henrychao521/esp32-camera-display/img/camera-filter.jpg

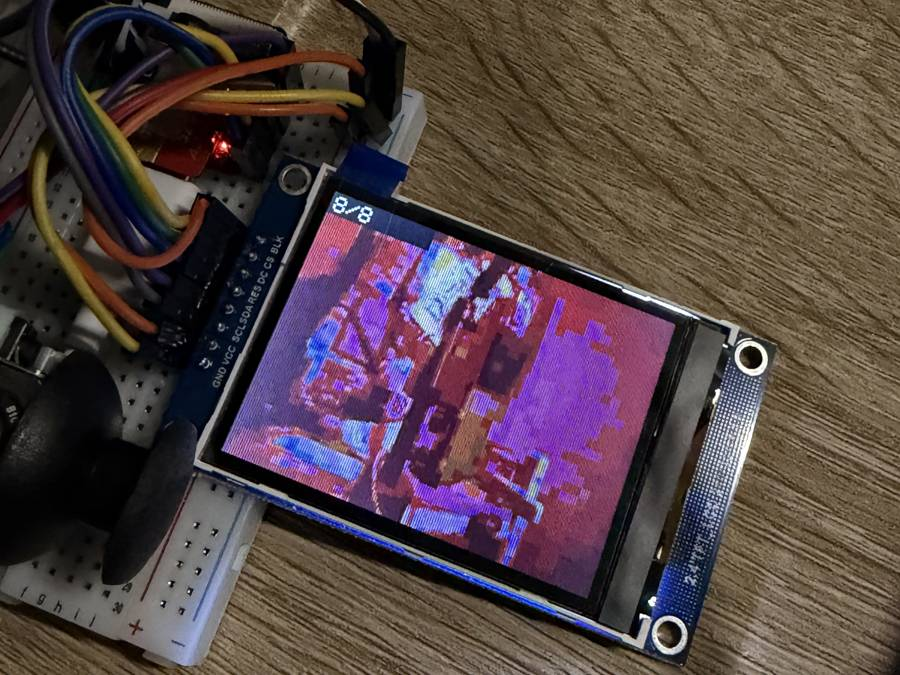
img/camera-filter.jpg
