henrychao521/esp32-camera-display/img/camera-display.jpg

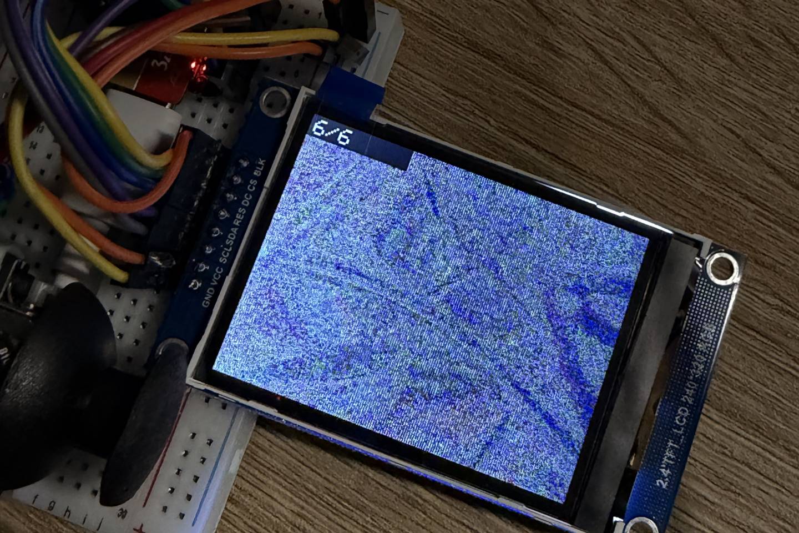
img/camera-display.jpg
