henrychao521/esp32-camera-display/README.md

# XIAO ESP32-S3 迷你即時取景相機

用 **Seeed XIAO ESP32-S3 Sense(內建 OV2640 鏡頭)** 擷取畫面,即時顯示在
**2.4" ILI9341 SPI TFT(240×320,無觸控)** 上,做成一台小相機。

**功能**:即時取景(全程 JPEG)、拍照(EXIF 時間)、濾鏡、相簿、MJPEG 錄影、
WiFi 傳檔 + OTA、螢幕省電;**支援 OV2640 / OV5640 自動偵測**,換 OV5640 時
自動啟用**自動對焦 + 搖桿 tap-to-focus**。

## 一、元件清單(照片中的東西)

| 元件 | 說明 | 在本專案的角色 |
|---|---|---|
| XIAO ESP32-S3 Sense | 主控 + OV2640 相機(鏡頭已在擴充板上) | 抓影像、驅動顯示器 |
| 2.4" ILI9341 SPI TFT | 240×320,SPI 介面,**不支援觸控** | 顯示即時畫面 |
| 搖桿模組(KY-023) | 類比 XY + 按鈕 | **選配**:按鈕凍結畫面 |
| 麵包板 | 免焊麵包板 | 固定接線 |
| 杜邦線 ×2 包 | 公對公 | 接線 |

> 重點:相機是透過 Sense 擴充板「內部」連到 XIAO(底部 B2B 連接器),
> **不會佔用外露的 D0~D10 排針**,所以顯示器與搖桿都能用外露腳位。

## 二、實作流程總覽

1. **裝好環境**:Arduino IDE + ESP32 開發板套件 + Arduino_GFX 函式庫。
2. **接線**:先只接顯示器(5 條訊號 + 電源),搖桿最後再接。
3. **燒錄基本顯示測試**(可選),確認顯示器會亮、顏色正常。
4. **燒錄 `camera_display.ino`**:相機 → 顯示器即時取景。
5. **微調**:畫面上下顛倒 / 顏色偏色,用程式裡的翻轉、Be 位元序選項調。
6. **(選配)接搖桿**,做凍結畫面等互動。

## 三、接線方式

XIAO 外露腳位的 **D 編號 ↔ GPIO 編號** 對照(程式碼裡用的是 GPIO 編號):

| D 編號 | GPIO | 用途 |
|---|---|---|
| D0 | 1 | TFT RES(RESET) |
| D1 | 2 | TFT CS |
| D3 | 4 | TFT DC |
| D8 | 7 | TFT SCL(時脈) |
| D9 | 8 | (空著,此顯示器無 MISO) |
| D10 | 9 | TFT SDA(資料) |
| D2 | 3 | 搖桿 VRx(選配) |
| D4 | 5 | 搖桿 VRy(選配) |
| D5 | 6 | 搖桿 SW 按鈕(選配) |

### 顯示器接線表(依實機絲印:8 pin)

實機顯示器絲印為 `GND VCC SCL SDA RES DC CS BLK`(共 8 pin,**無 MISO**)。
`SCL/SDA` 是 SPI 的時脈/資料,**不是 I2C**,只是這家廠商的命名。

| 顯示器絲印 | 別名 | 接到 XIAO | 說明 |
|---|---|---|---|
| GND | GND | GND | 共地 |
| VCC | VCC | **3V3** | 用 3.3V(邏輯同為 3.3V,最安全) |
| SCL | SCK / CLK | D8 (GPIO7) | SPI 時脈 |
| SDA | MOSI / SDI | D10 (GPIO9) | SPI 資料 |
| RES | RST / RESET | D0 (GPIO1) | 重置 |
| DC | DC / RS | D3 (GPIO4) | 資料/命令 |
| CS | CS | D1 (GPIO2) | 晶片選擇 |
| BLK | LED / BL | **3V3** | 背光電源 |

> 此板無 MISO 腳,程式中 `TFT_MISO` 設為 `-1`,原本的 D9 空著即可。

> ⚠️ **電源提醒**:此模組請用 **3.3V** 供電(VCC 與 BLK 都接 3V3)。
> XIAO 的邏輯是 3.3V,若把 VCC 接 5V 而未做準位轉換,命令可能異常。
> 用 USB 供電時 XIAO 的 3V3 足以帶動這片顯示器與背光。

> 🔎 **驅動晶片**:外盒標示 ILI9341,程式預設用 `Arduino_ILI9341`。
> 若螢幕空白/亂碼,可能其實是 ST7789,把程式裡的 `Arduino_ILI9341`
> 改成 `Arduino_ST7789` 再燒錄即可(這類 8-pin SCL/SDA 藍板常見兩種晶片)。

### 搖桿(KY-023,選配)接線表

| 搖桿腳位 | 接到 XIAO | 說明 |
|---|---|---|
| GND | GND | 共地 |
| +5V | 3V3 | 供電(接 3.3V 即可,類比範圍 0~3.3V) |
| VRx | D2 (GPIO3) | X 軸類比(ADC) |
| VRy | D4 (GPIO5) | Y 軸類比(ADC) |
| SW | D5 (GPIO6) | 按鈕(內部上拉,按下為低電位) |

程式中 `USE_JOYSTICK` 設 `true` 才會啟用;沒接就設 `false`。

### 供電方式(推薦:行動電源 → XIAO → 分電)

最簡單的做法是用**行動電源經 USB-C 供電給 XIAO**,再由 XIAO 分電給其他元件:

```
行動電源 ──USB-C──► XIAO USB 孔
                     │
                     ├─ 3V3 腳 ──► 顯示器 VCC / LED、搖桿 +
                     └─ GND 腳 ──► 顯示器 GND、搖桿 GND(共地)
```

- **顯示器 VCC/LED 接 `3V3`**(不要接 5V,邏輯才與 XIAO 的 3.3V 一致)。
- **共地**:所有元件的 GND 都回到 XIAO 的 GND(全接在 XIAO 上本來就共地)。
- **電流預算**:相機 + 顯示器 + 背光約 250~350mA,XIAO 板上 3V3 穩壓器帶一片
  ILI9341 綽綽有餘。
- **行動電源自動斷電**:部分行動電源在耗流過低(<50~100mA)時會自動關機;
  本專案「相機 + 背光」耗流遠高於此門檻,正常運作不會被關掉。
- ⚠️ `3V3` 是**輸出**腳:只由 USB 端供電後往外送,**切勿**再從 `3V3` 灌入
  另一顆外部電源,以免電源打架。維持「單一來源(行動電源)→ XIAO → 分電」最安全。
- (進階)XIAO ESP32-S3 板子背面有 BAT+/BAT− 焊墊可直接接鋰電池,
  但用行動電源走 USB 是最省事、免焊的做法。

## 四、軟體環境設定

1. **安裝 ESP32 開發板套件**
   Arduino IDE → 偏好設定 → 額外開發板管理員網址加入:
   `https://raw.githubusercontent.com/espressif/arduino-esp32/gh-pages/package_esp32_index.json`
   然後在「開發板管理員」安裝 **esp32 by Espressif**(建議 3.x)。

2. **安裝函式庫**(程式庫管理員搜尋安裝)
   - **GFX Library for Arduino**(作者 Moon On Our Nation)— 驅動顯示器
   - **TJpg_Decoder**(作者 Bodmer)— 即時取景/相簿/錄影解碼 JPEG
   - **OV5640 Auto Focus for ESP32 Camera**(作者 0015)— 換 OV5640 才需要;OV2640 可略過
   > 選 Arduino_GFX 的原因:所有腳位/驅動都寫在 `.ino` 裡,不用改函式庫檔。

3. **開發板設定(工具選單)**
   - 開發板:`XIAO_ESP32S3`
   - **PSRAM:`OPI PSRAM`** ← 必開,否則相機 frame buffer 配不到記憶體
   - USB CDC On Boot:`Enabled`(方便看 Serial 訊息)

4. **燒錄**:把 `camera_display.ino` 與 `camera_pins.h` 放同一資料夾開啟,
   選好序列埠 → 上傳。

## 五、運作原理(簡述)

- 相機**全程用 `PIXFORMAT_JPEG` + `FRAMESIZE_QVGA`(320×240)**:即時取景、拍照、
  錄影都用同一個格式,不再中途切換(早期版本取景用 RGB565、拍照才切 JPEG,
  切換會重置感光元件、拍照卡頓,也讓 OV5640 對焦韌體被清掉)。
- 即時取景把每張 JPEG 用 **`TJpgDec.drawJpg()`** 解碼上螢幕(和錄影/相簿同一條路),
  搭配 `TJpgDec.setSwapBytes(false)` 顏色才正確。
- 顯示器 `rotation=1`(橫向)後解析度是 320×240,和相機輸出一致,不必縮放。
- 好處:拍照只需抓最新影格直接存,**不用切格式、不卡頓**;OV5640 對焦韌體開機
  載入一次即可常駐(見第六之五節)。

## 六、常見問題排解

| 症狀 | 可能原因 / 解法 |
|---|---|
| 顯示器全白 / 沒反應 | 檢查 CS/DC/RES/SCL/SDA 是否接對;VCC、GND、BLK 是否有接 |
| 顯示器空白 / 亂碼(接線都對) | 晶片可能是 ST7789,把 `Arduino_ILI9341` 改成 `Arduino_ST7789` |
| 開機顯示 `Camera init FAIL` | PSRAM 沒設成 `OPI PSRAM`;或開發板沒選 `XIAO_ESP32S3` |
| **拍的照片損毀/雜訊**(即時預覽卻正常) | XIAO Sense 已知坑:XCLK 要用 **10MHz**,20MHz 會產生損毀影格(`EV-VSYNC-OVF`) |
| **相簿/影片預覽紅藍互換** | `TJpgDec.setSwapBytes(false)`(搭配 Arduino_GFX 的 `draw16bitRGBBitmap`) |
| 畫面上下/左右顛倒 | 改頂部 `CAM_VFLIP` / `CAM_HMIRROR`(0/1);換 OV5640 已預設 `CAM_VFLIP 1` |
| 顏色紅藍互換 | 確認 `TJpgDec.setSwapBytes(false)`(即時取景/相簿/錄影都走這條解碼路) |
| 畫面太暗 / 背光不亮 | 確認 BLK 有接 3V3;供電請用 USB 而非弱電池 |
| 更新很卡 | 確認用硬體 SPI(本範例已是);可試著提高 SPI 時脈或維持 QVGA |

## 六之一、搖桿操作(功能表)

```
相機模式(即時取景)
  ├─ 點按搖桿鍵  → 拍照(存 JPEG 到 SD)
  ├─ 搖桿方向    → (OV5640)移動對焦準星 tap-to-focus,對到該點;閒置 3 秒回連續對焦
  └─ 長按搖桿鍵  → 開啟功能表
功能表(搖桿上下選、點按進入、長按回相機)
  ├─ Filter  濾鏡  → 左右切特效(Normal/Negative/B&W/Red/Green/Blue/Sepia)
  │                  上下調亮度、點按返回
  ├─ Gallery 相簿  → 左右翻看 SD 卡照片、點按返回
  ├─ Video   錄影  → 點按開始/停止錄影、長按返回
  └─ Back    回相機
```

- **錄影格式**:MJPEG 存成 `.avi`(`/VID00000.AVI`…)。**無聲音**、約 5–15fps、
  播放速度依實際幀率自動校正。用 VLC 等播放器可直接開。
- **方向相反**:若搖桿上下或左右操作相反,調 `pollJoyDir()` 裡的門檻對調即可。
- 搖桿接線:VRx→D2、VRy→D4、SW→D5、`+`→3V3、GND→GND。

## 六之二、加裝 microSD 卡拍照

- **格式**:格式化成 **FAT32**(32GB 建議 FAT32,**勿用 exFAT**,ESP32 常掛載失敗)。
  Mac:磁碟工具 → 清除 → 格式「MS-DOS (FAT)」、架構「主開機記錄(MBR)」。
- **接線**:XIAO ESP32-S3 Sense 內建 SD 卡槽,**不用外接線**,插卡即可。
  SD 卡與顯示器**共用 SPI**:SCK=D8、MOSI=D10、**MISO=D9**、SD_CS=GPIO21(內部)。
- **程式**:顯示器改用 `Arduino_HWSPI`(共享匯流排),`TFT_MISO` 設回 D9(GPIO8)。
- **操作**:即時取景時**按一下搖桿按鈕**,把當前畫面存成 `/IMG00000.JPG`(依序遞增),
  螢幕上方會顯示存檔結果。無卡或寫入失敗會顯示紅字提示。
- **拍照方式**:相機全程都是**原生 JPEG**,按下時直接抓最新影格存檔(顏色正確、不用切格式,
  拍照**不再卡頓**)。換 OV5640 時會先等對焦鎖定(約 1 秒內)再擷取,照片才清晰。

## 六之三、WiFi 傳照片 + EXIF 時間(功能表 `WiFi Send`)

**流程**:功能表選 `WiFi Send` → ESP32 開熱點 → 手機加入 → 網頁自動彈出 → 瀏覽/下載照片。

- **手機端免 App**:XIAO 開成 WiFi 熱點(SSID `XIAO-CAM` / 密碼 `12345678`,可在程式改),
  手機加入後 **Captive Portal** 會自動彈出相簿網頁(iOS 尤其順)。也可手動開螢幕上的 IP。
- **對時**:AP 模式沒有網路,無法 NTP;改由**手機瀏覽器**在開啟網頁時把時間傳給 ESP32
  (`/settime`),之後拍照就會寫入 **EXIF 時間**(型號 `XIAO ESP32S3 Sense` + 拍攝時間)。
  ⚠️ ESP32 斷電後 RTC 歸零,每次開機連一次網頁即可重新對時(下一版會加 BLE 開機自動對時)。
- **OTA 更新**:網頁上點 `Firmware update (OTA)`,選 `.bin` 上傳即可無線更新韌體。
- **顯示**:WiFi 模式只顯示連線資訊 + 連線數/已傳檔數 + 時鐘;按搖桿鍵結束並關閉 WiFi。
- **免裝新函式庫**:WiFi / WebServer / DNSServer / Update 都是 ESP32 核心內建。

## 六之四、螢幕自動關閉 / 喚醒

- 閒置 **30 秒**(可改 `SCREEN_TIMEOUT_MS`)自動關螢幕;**按搖桿鍵喚醒**
  (喚醒的那一下只喚醒、不會誤觸拍照/選單)。
- **錄影中、WiFi 傳輸中不會自動關**,以免中斷。
- **省電程度看背光接法**:
  - 預設 `BLK_PIN = -1`(免改線):用 `displayOff()` 讓畫面變黑,但 BLK 接 3V3 常亮,
    螢幕會「黑但微亮」,省電有限。
  - **真正關背光**:把顯示器 **BLK 從 3V3 改接一支 GPIO**(建議 **D6 = GPIO43**,USB 當 Serial 時這支是空的),
    再把程式的 `#define BLK_PIN` 改成 `43`,就能完全關背光、最省電。

## 六之五、換成 OV5640 相機(含自動對焦)

OV5640(500 萬畫素)與 OV2640 **共用同一排線接頭**,`esp_camera` 會自動偵測型號
(程式讀 `sensor->id.PID == 0x5640`),所以**接線與 `camera_pins.h` 都不用改**。

**程式已內建 OV5640 支援,換上去要注意:**

- **XCLK 時脈**:頂部 `#define CAM_XCLK_HZ` 用 **20000000**(OV5640 建議 20MHz;
  換回 OV2640 用 10000000)。
- **畫面方向**:此模組裝上後畫面上下顛倒,已預設 `#define CAM_VFLIP 1` 修正;
  若你的模組**左右也反**,再把 `CAM_HMIRROR` 設 1(等同旋轉 180°)。
- **自動對焦(已實作)**:需在程式庫管理員裝 **「OV5640 Auto Focus for ESP32 Camera」**。
  開機偵測到 OV5640 就自動 `focusInit()` 下載對焦韌體 → `autoFocusMode()` **連續對焦**;
  拍照前會等 `getFWStatus()==0x10`(對焦完成)再擷取。OV2640 會自動略過、不受影響。
  - ⚠️ **硬體**:OV5640 模組的 **AF-VCC 要接 3.3V**,對焦馬達(VCM)才會動;
    沒接的話序列埠會印「AF 韌體載入失敗」,焦點不會移動。
- **Tap-to-focus**:即時取景時**搖桿方向移動對焦準星**,對焦到該點(韌體命令 `0x81`);
  準星對焦完成轉綠,閒置 3 秒回全畫面連續對焦。
  - 觸控區域座標(程式用 0..0x50 / 0..0x3C)不同模組可能需微調;若準星動但焦點不跟,
    調 `afFocusAtReticle()` 的座標映射即可。

可再延伸:**高解析度拍照**——OV5640 最高 QSXGA(2592×1944),可只在拍照時切到高解析度,
相簿顯示再用 `TJpgDec.setJpgScale()` 縮圖。

## 七、可延伸方向

> 拍照存檔、搖桿選單/濾鏡、WiFi 傳檔+OTA、螢幕省電、OV5640 自動對焦皆已實作,
> 以下是還沒做的方向:

- **高解析度拍照**:OV5640 最高 QSXGA(2592×1944),拍照時切到高解析度存檔。
- **主體對焦**:用 **ESP-DL 人臉偵測**(比 YOLO 輕很多)取得人臉框,把對焦準星
  自動對到人臉;物件辨識則適合留給「相簿離線標記」(對已存照片離線分類)。
- **Wi-Fi 串流**:同一顆 XIAO 也能同時跑 MJPEG 網頁串流,手機看即時畫面。

## 檔案

- `camera_display.ino` — 主程式
- `camera_pins.h` — OV2640 for XIAO ESP32-S3 Sense 腳位定義
