henrychao521/esp32-camera-display/img/camera-side.jpg

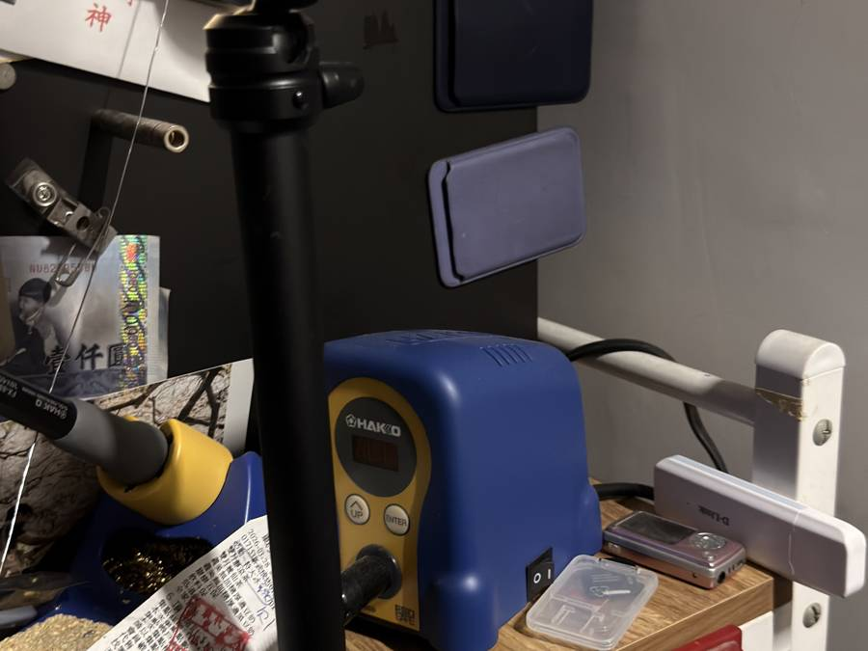
img/camera-side.jpg
