henrychao521/esp32-camera-display/(commit log)

2026-07-15 首次提交:XIAO ESP32-S3 Sense + ILI9341 迷你相機
    - camera_display.ino:主程式(即時取景/拍照/濾鏡/相簿/MJPEG 錄影/搖桿)
    - camera_pins.h:OV2640 腳位
    - README.md:完整說明
    - web/:開發歷程與互動接線圖 + index.html 導覽頁
2026-07-15 修正導覽頁深色模式:卡片白底淺字看不清
    深色 @media 區塊原本寫在基礎 a.card 規則之前,同權重被後面的
    background:#fff 覆蓋,導致深色模式下卡片仍白底但文字淺色。
    把深色區塊移到樣式表最後,並補齊副標/頁尾的深色配色。
2026-07-16 更新至 phase-2:SD/EXIF、選單、WiFi 傳檔+OTA、螢幕省電、BLE 尋找、OV5640
    同步來源分支 claude/esp32-camera-display-thvra8 @ b9bfec8
    - camera_display.ino:新增 SD 卡儲存/EXIF、選單、WiFi 傳檔與 OTA、螢幕省電、藍牙尋找、OV5640 支援
    - README.md / camera_pins.h:配合更新
    - web/devlog.html:phase-2 功能演進紀錄
2026-07-16 devlog:除錯六關改用實拍照片,補 meta charset
    - 關卡 3~6 的模擬 glitch canvas 換成當時手機翻拍的真實失敗畫面
    (迷幻塗抹/藍色雜訊/半屏損毀/紅藍互換),標籤由「重現」改「實拍」
    - 照片經 EXIF 轉正、縮至寬 640、內嵌 base64(自包含)
    - 新增 .glitch .ph 樣式(保留直式比例,不裁切)
    - 補 <meta charset=utf-8>(原本缺,直接開檔會亂碼)
2026-07-16 OV5640:加入自動對焦、修正畫面上下顛倒
    - CAM_VFLIP 0→1:換 OV5640 後畫面上下顛倒,垂直翻轉修正
    - 新增 OV5640 自動對焦(函式庫 0015/ESP32-OV5640-AF):
    * initCamera() 尾端偵測 PID=0x5640 → focusInit() 載入 AF 韌體 → autoFocusMode() 連續對焦
    * OV2640 自動略過,不受影響
    * 切換 RGB565⇄JPEG 會重置感光元件,故 AF 於每次 initCamera 重載
    * 拍照切到 JPEG 後 afWaitFocused() 等對焦鎖定(getFWStatus==0x10)再擷取
    - 檔頭補上函式庫需求與 AF-VCC 需接 3.3V 提醒
    需 Library Manager 安裝「OV5640 Auto Focus for ESP32 Camera」;此改動需上板實測。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
    [camera_display.ino]
2026-07-16 OV5640:tap-to-focus + 即時取景改全程 JPEG(去除拍照卡頓)
    - 即時取景改用相機原生 JPEG + TJpg 解碼(和錄影/相簿同一條路):
    取景/拍照/錄影全程 JPEG、不再切換格式,AF 韌體開機載一次即可,拍照不再卡頓
    * 移除 setCamFormat();savePhoto/VIDEO 不再切格式;setup 以 PIXFORMAT_JPEG 啟動
    - 新增 tap-to-focus:LIVE 用搖桿移動準星,觸控對焦到該點(韌體命令 0x81 +
    座標 0x3024/0x3025),閒置 3 秒回連續對焦;準星對焦完成轉綠
    - devlog「升級 OV5640」卡片補上:方向修正(VFLIP=1)、自動對焦、tap-to-focus、
    JPEG-always 架構調整、以及『為何不用 YOLO』決策說明
    需上板實測;ta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
    [camera_display.ino]
2026-07-16 修正編譯錯誤:enterSelected() 重複的 case 3/4;清除 %u 格式警告
    - enterSelected() 改 case 2 時誤留原本的 case 3/4 → duplicate case value,移除多餘兩行
    - aviEnd()/VIDEO 的 Serial/gfx printf:uint32_t 用 %lu(+ (unsigned long) 轉型)消除 -Wformat 警告
    [camera_display.ino]
2026-07-16 文件更新:README + devlog 對齊現況(全程 JPEG、OV5640 自動對焦、tap-to-focus)
    - README:運作原理改全程 JPEG;函式庫加 OV5640 AF;操作加 tap-to-focus;
    拍照方式改不卡頓;六之五 OV5640 段改寫(AF 已實作/VFLIP=1/AF-VCC/tap-to-focus);
    可延伸方向更新;開頭補功能總覽;修正過時的顏色/翻轉排解列
    - devlog:OV5640 卡片加『已上板驗證』實測列
    - repo description 同步更新
2026-07-16 新增給國小生的科普文章頁 web/kids.html「動手做相機」
    - 光學/針孔成像、透鏡聚焦與對焦、鏡子反射、感光元件(像素)四大概念,
    每段附 SVG 插圖 + 在家可做的小實驗與安全提醒(暑假自由研究導向)
    - 含程式下載區(ZIP/主程式/GitHub)與接線圖、開發歷程連結
    - 首頁 index.html 加入該文章卡片入口
2026-07-16 下線國小生文章:移除 web/kids.html 與首頁入口(改為不公開)
    文章檔案保留在本機 ~/Downloads/動手做相機_kids.html,未來要發布再放回。
2026-07-16 wiring-guide:頁尾加入「04 程式碼」區——線上可讀 + 一鍵下載
    - 內嵌 camera_display.ino 與 camera_pins.h(HTML 轉義,可捲動閱讀)
    - 下載鈕:JS Blob 下載 .ino/.h、GitHub ZIP、原始碼連結;每段附複製鈕
    - 補 <meta charset=utf-8>(原本缺,避免本機開啟/下載內容變亂碼)
    - 沿用原頁主題感知樣式
2026-09-06 導覽頁改版「真實工坊」風：實拍相機照片滿版、文字列入口，新增 img/ 三張實拍
2026-09-06 導覽頁兩張照片改等寬
2026-09-07 圖片瘦身：三張實拍縮到顯示尺寸並加 WebP（image-set／picture），0.89 MB → 0.27 MB
2026-09-07 接線表與韌體對不起來、兩頁 quirks mode、手機首頁橫向溢出
    - 接線表要人把 BLK 接 3V3，但出貨韌體的 BLK_PIN 預設是 43(D6)。照表接的話
    休眠只會清空畫面、背光關不掉。表格改列 BLK → D6(GPIO43)，並註明若真要接
    3V3 就得把韌體改成 BLK_PIN -1，同時提醒 GPIO43 是 U0TXD、占用會失去序列埠
    傳送腳。接線圖上的「VCC+BLK → 3V3」一併更正
    - web/wiring-guide.html 與 web/devlog.html 都從 <meta> 開始，沒有 doctype 與
    html lang，瀏覽器以 quirks mode 呈現。補齊後 compatMode 為標準模式
    - 首頁 .hero h1 的 clamp 下限 4rem 在 390px 比容器還寬，整頁多出 22px 橫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
